molgan-tellus/1s_tps62823/jlcpcb_order/jlcpcb_respons/large/top_large.png

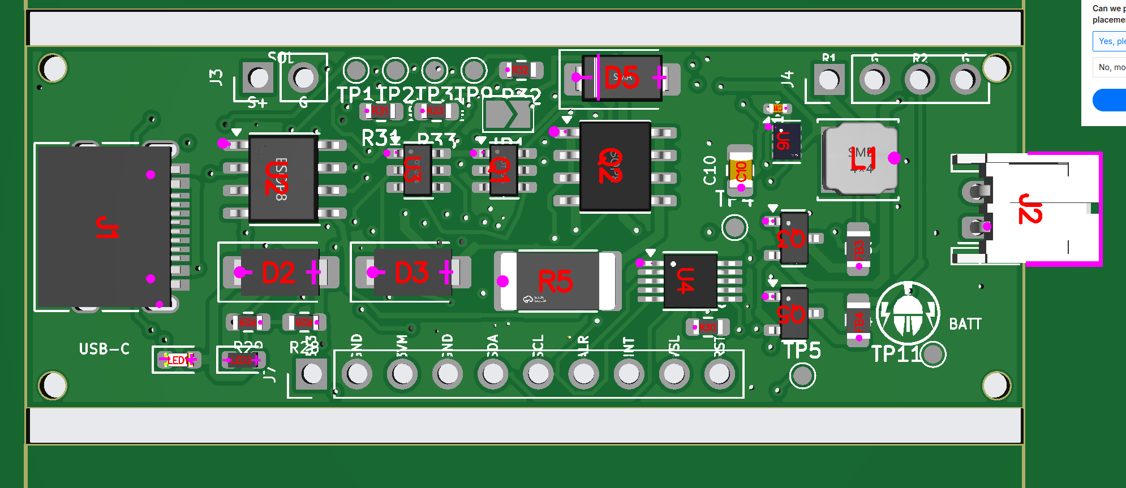
jlcpcb_order/jlcpcb_respons/large/top_large.png
