molgan-tellus/1s_tps62823/doc/jlpcb_a.png

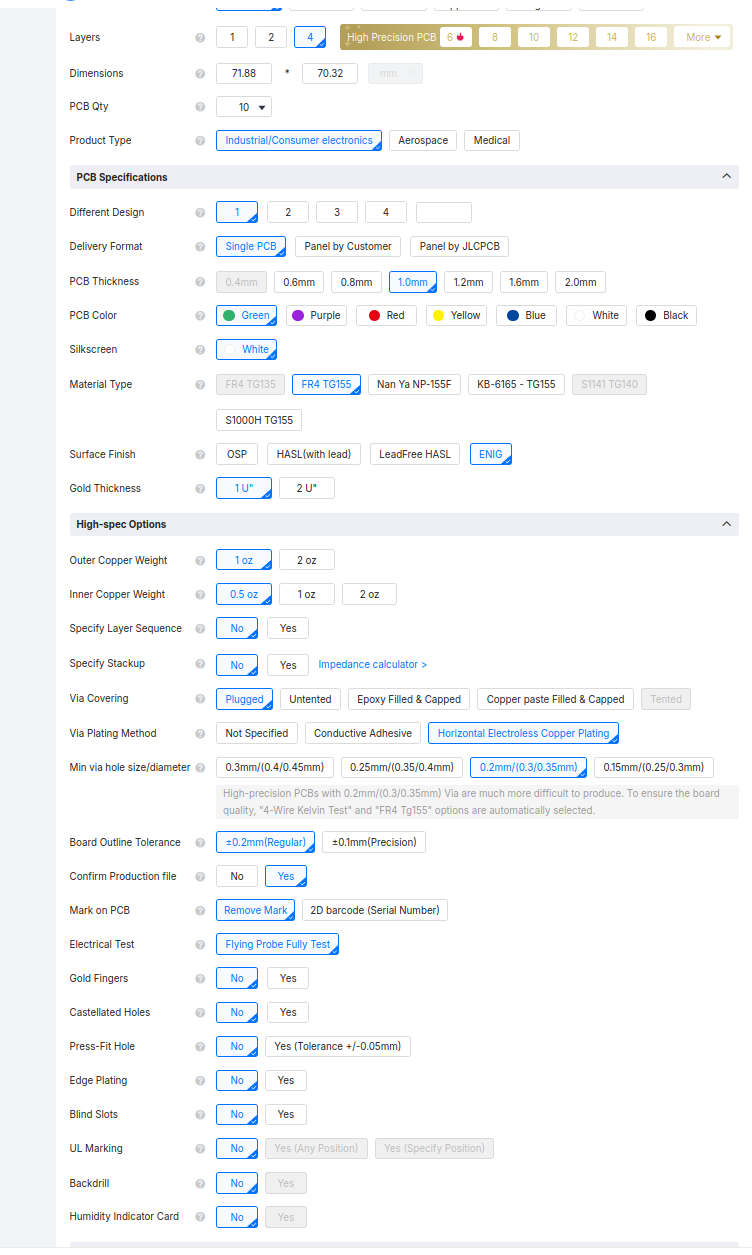
doc/jlpcb_a.png
