molgan-tellus/1s_tps62823/doc/jlpcb_b.png

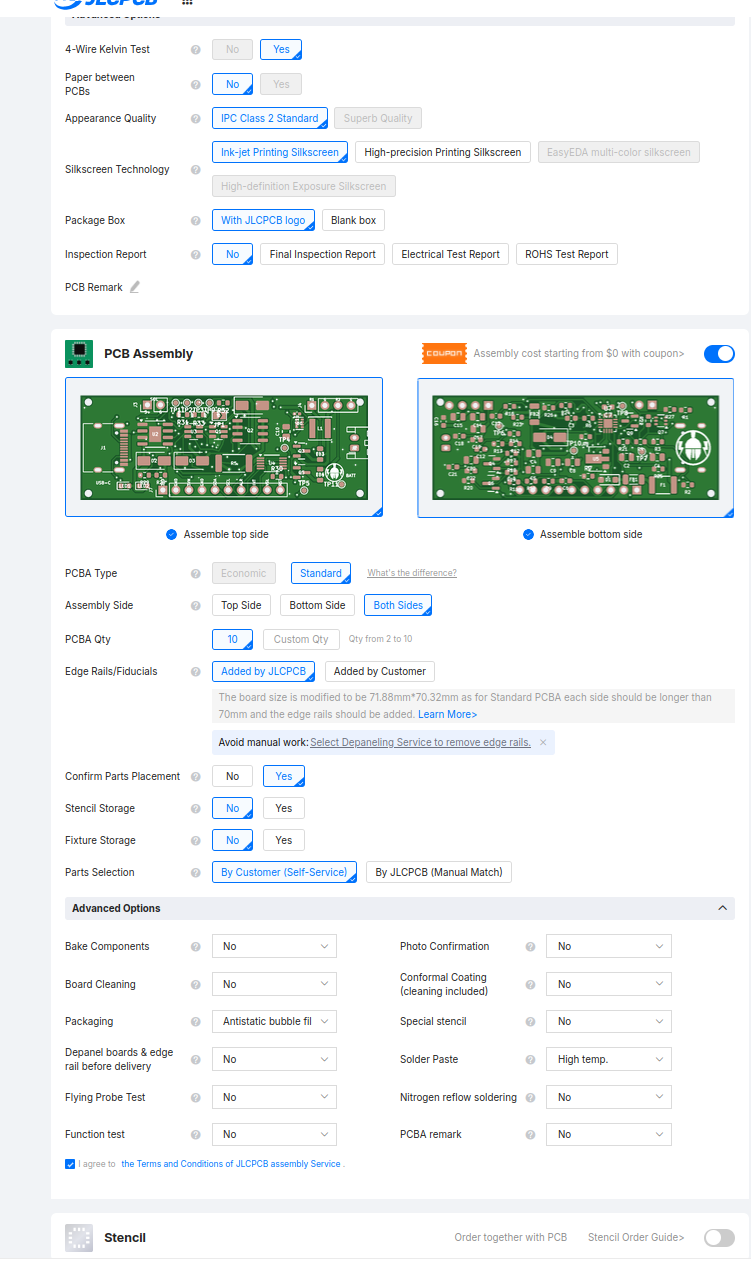
doc/jlpcb_b.png
