molgan-tellus/1s_tps62823/doc/render_back.png

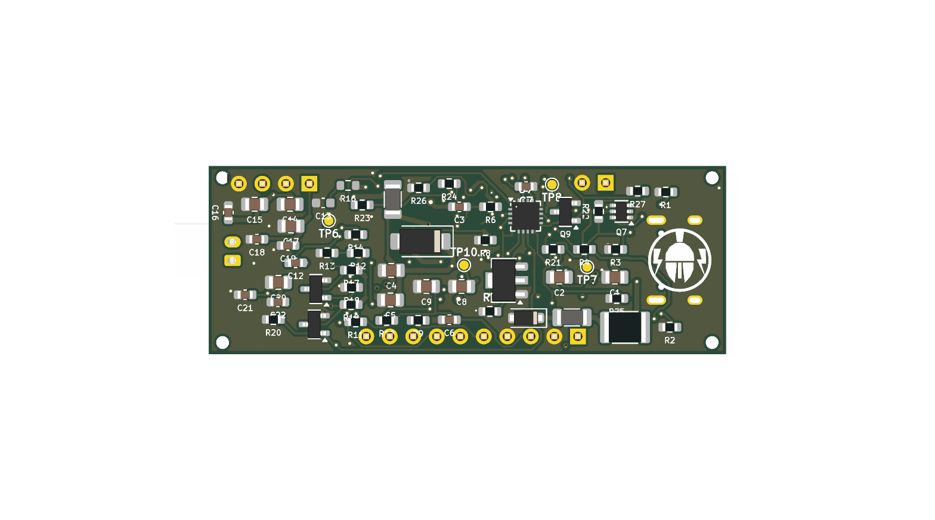
doc/render_back.png
