molgan-tellus/1s_tps62823/doc/render_front.png

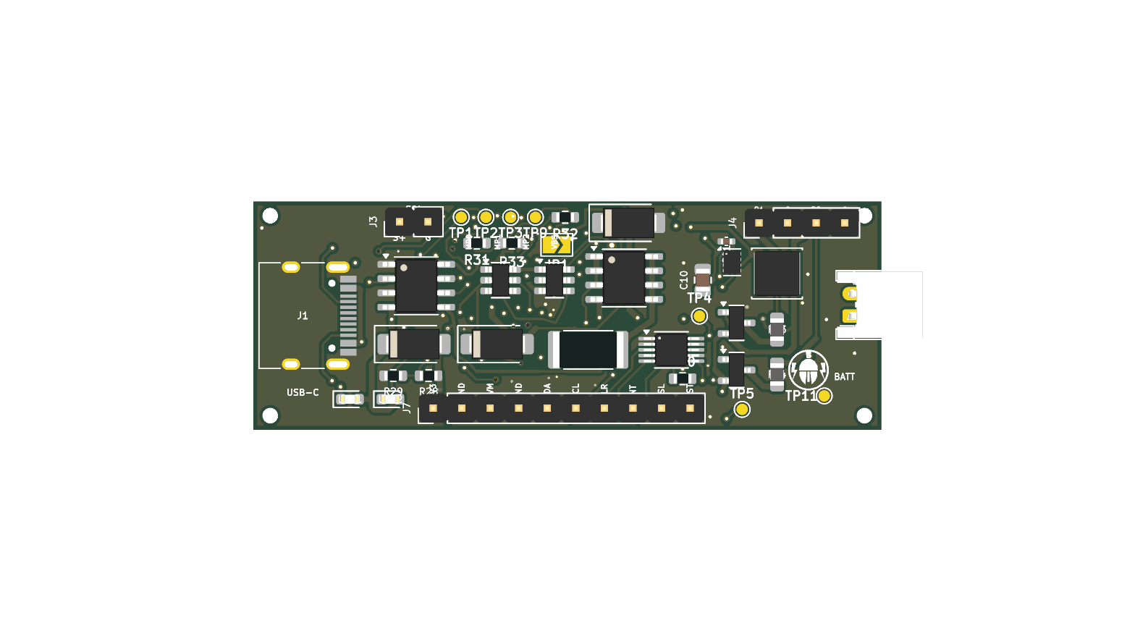
doc/render_front.png
