molgan-tellus/1s_tps62823/doc/render_persp.png

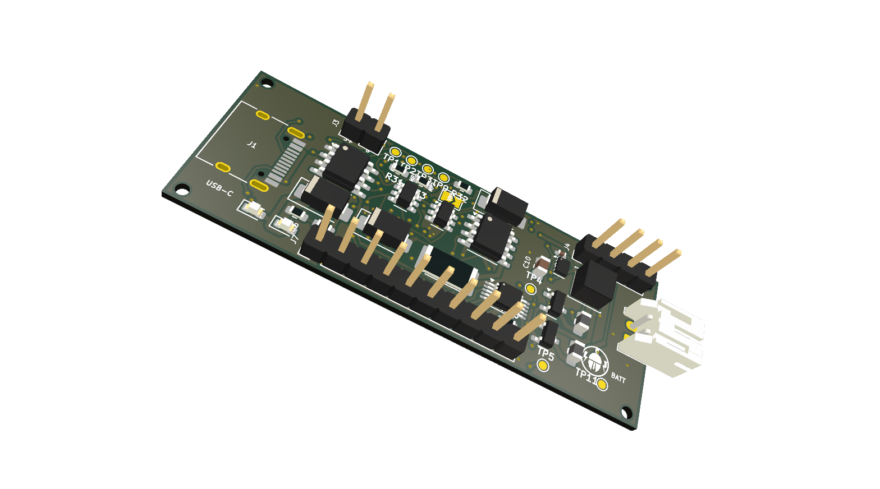
doc/render_persp.png
