molgan-tellus/1s_tps62823/jlcpcb_order/jlcpcb_respons/bom0.png

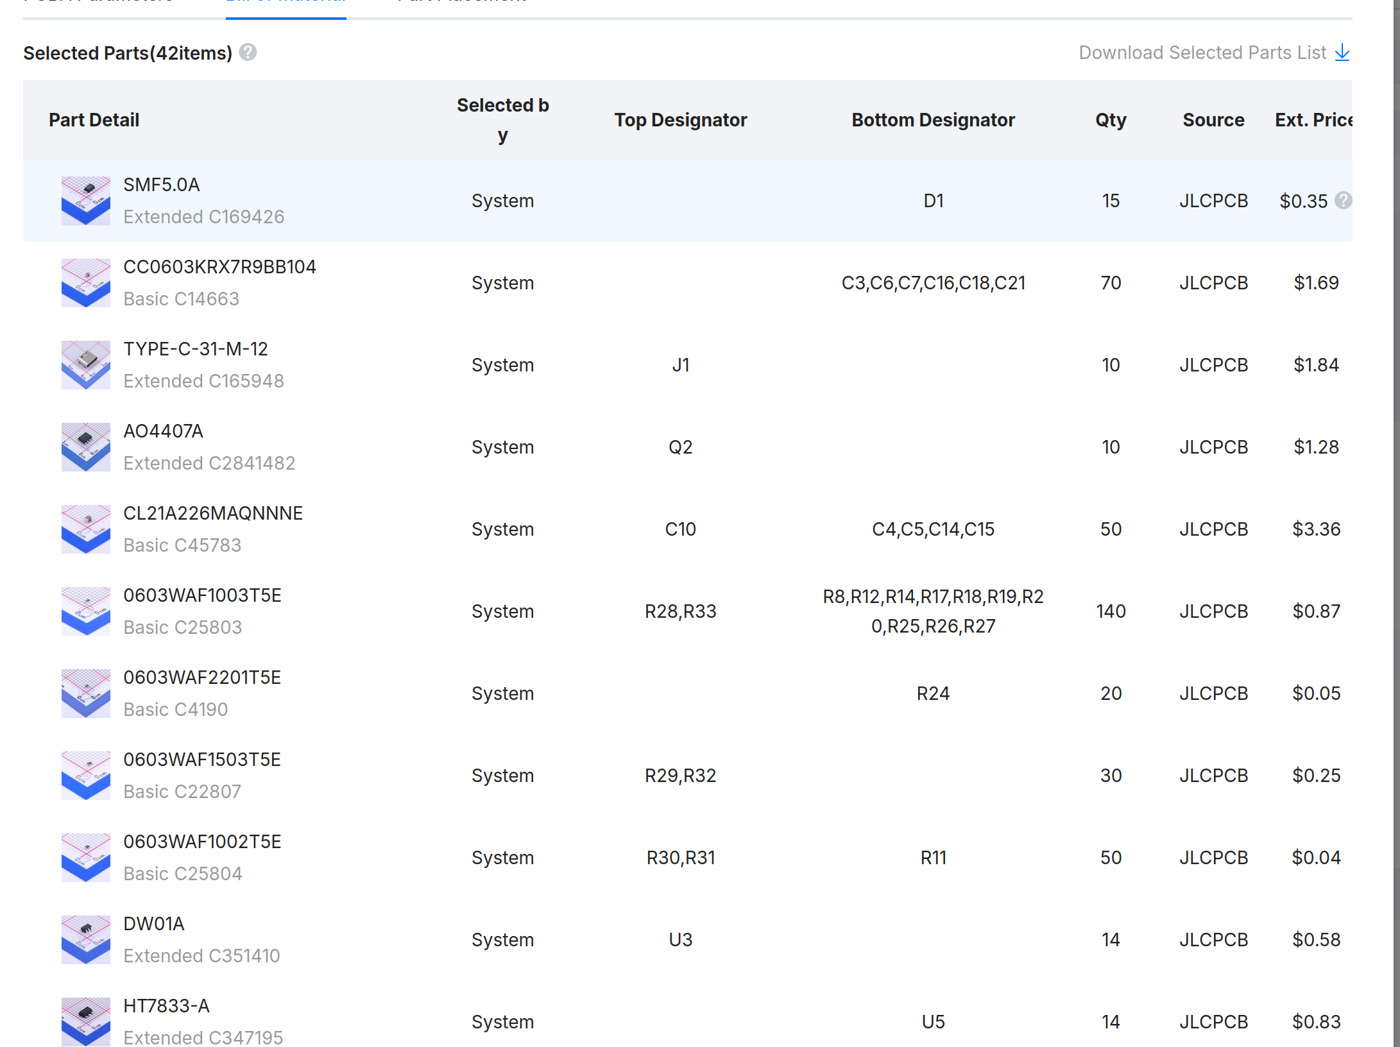
jlcpcb_order/jlcpcb_respons/bom0.png
