molgan-tellus/1s_tps62823/jlcpcb_order/jlcpcb_respons/bom2.png

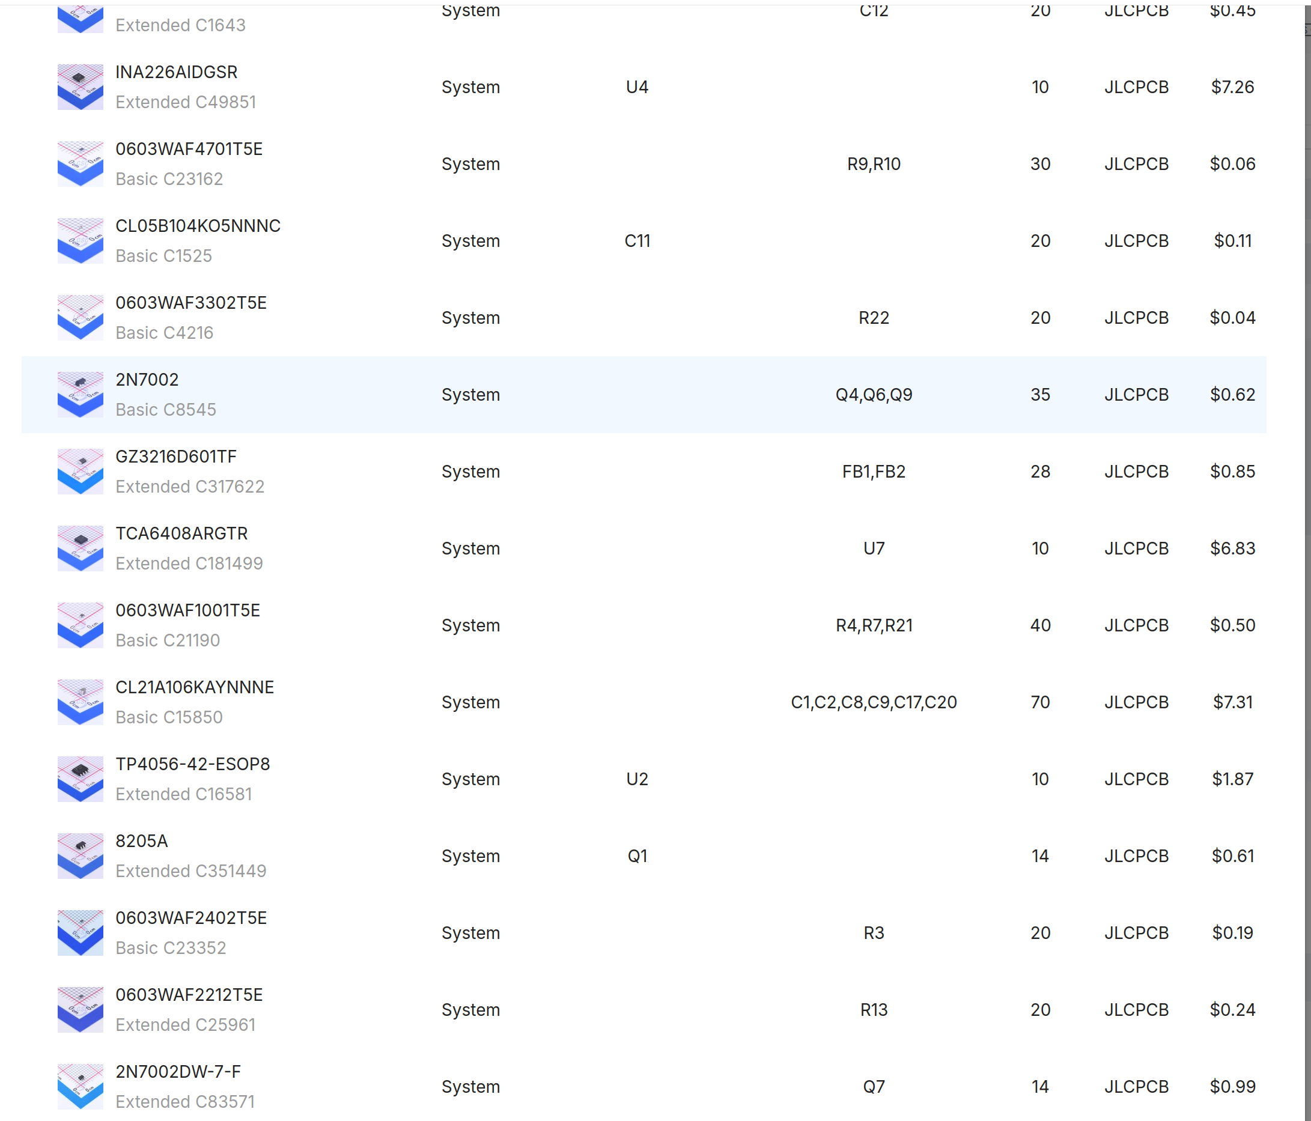
jlcpcb_order/jlcpcb_respons/bom2.png
