molgan-tellus/1s_tps62823/jlcpcb_order/jlcpcb_respons/bom3.png

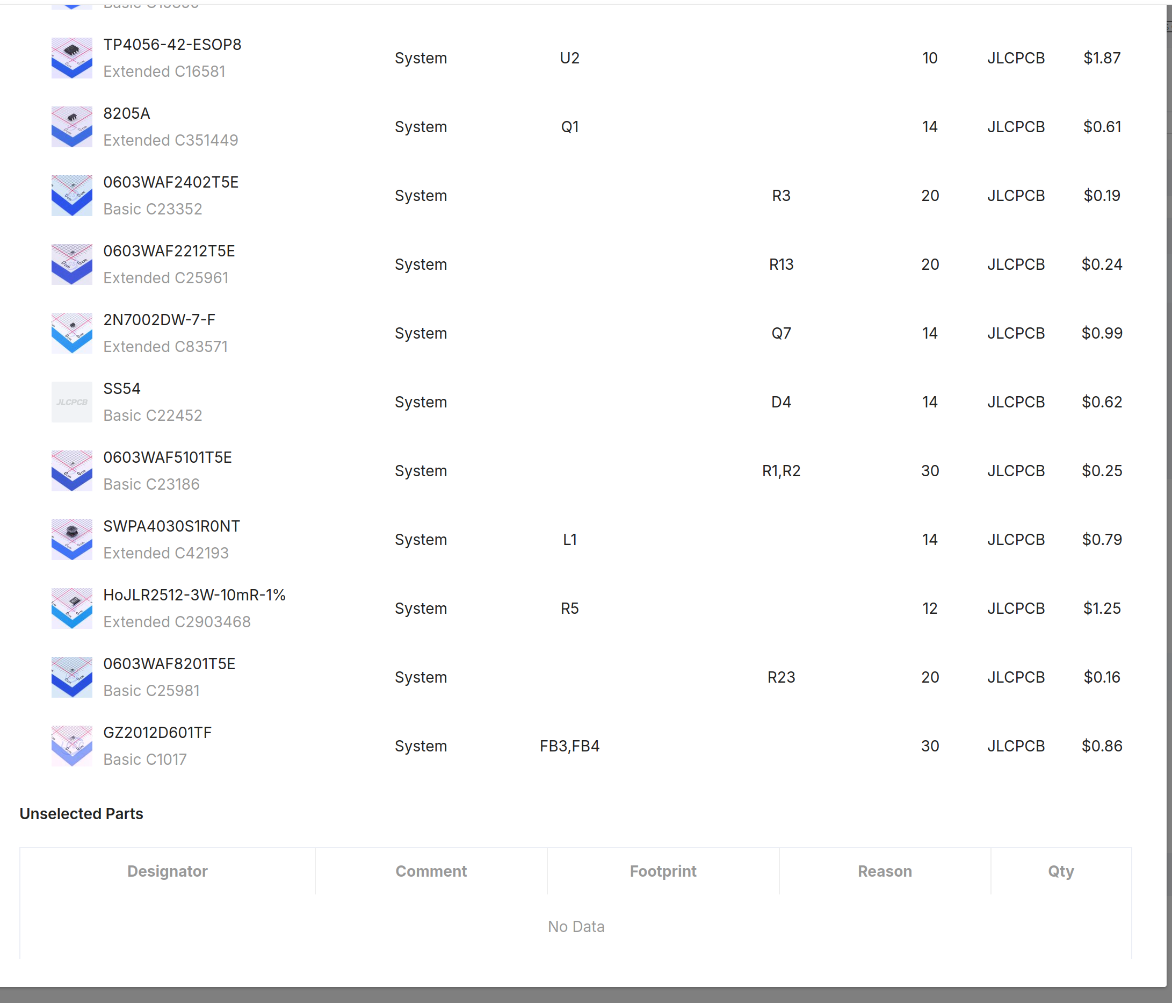
jlcpcb_order/jlcpcb_respons/bom3.png
