molgan-tellus/1s_tps62823/jlcpcb_order/jlcpcb_respons/bottom_correction.png

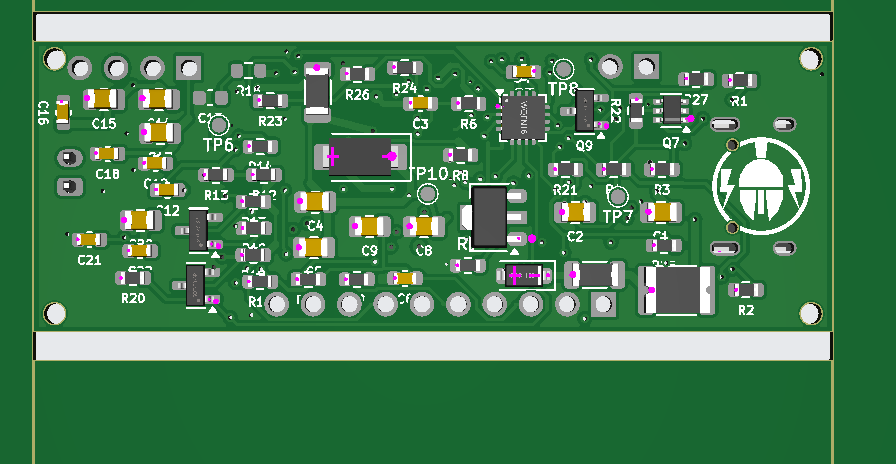
jlcpcb_order/jlcpcb_respons/bottom_correction.png
