molgan-tellus/1s_tps62823/jlcpcb_order/jlcpcb_respons/placement.png

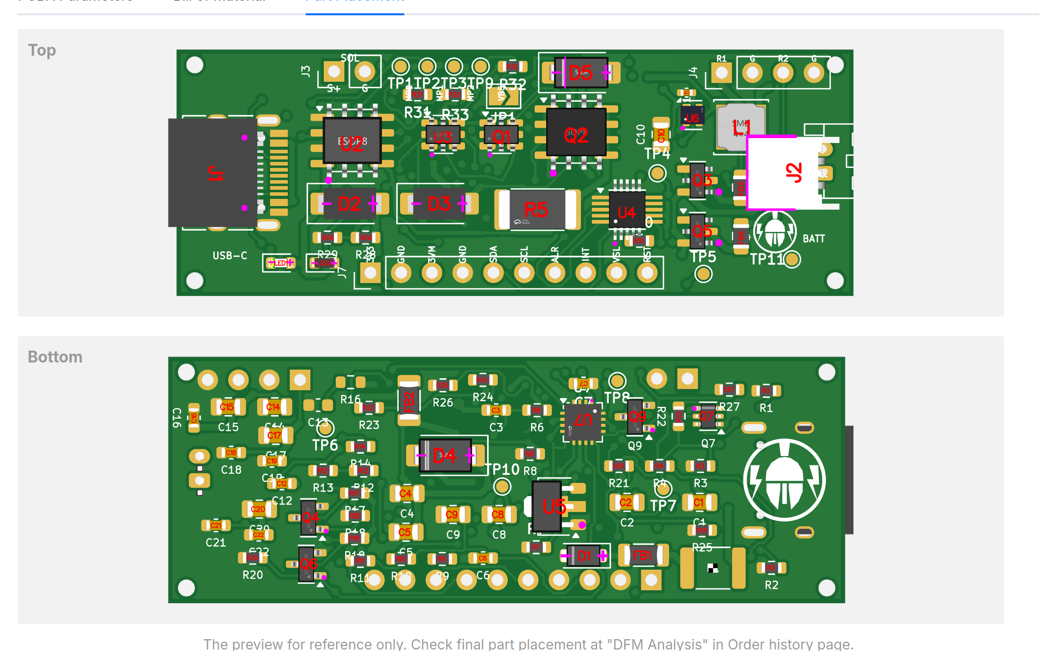
jlcpcb_order/jlcpcb_respons/placement.png
