molgan-tellus/1s_tps62823/jlcpcb_order/jlpcb_b_markerad.png

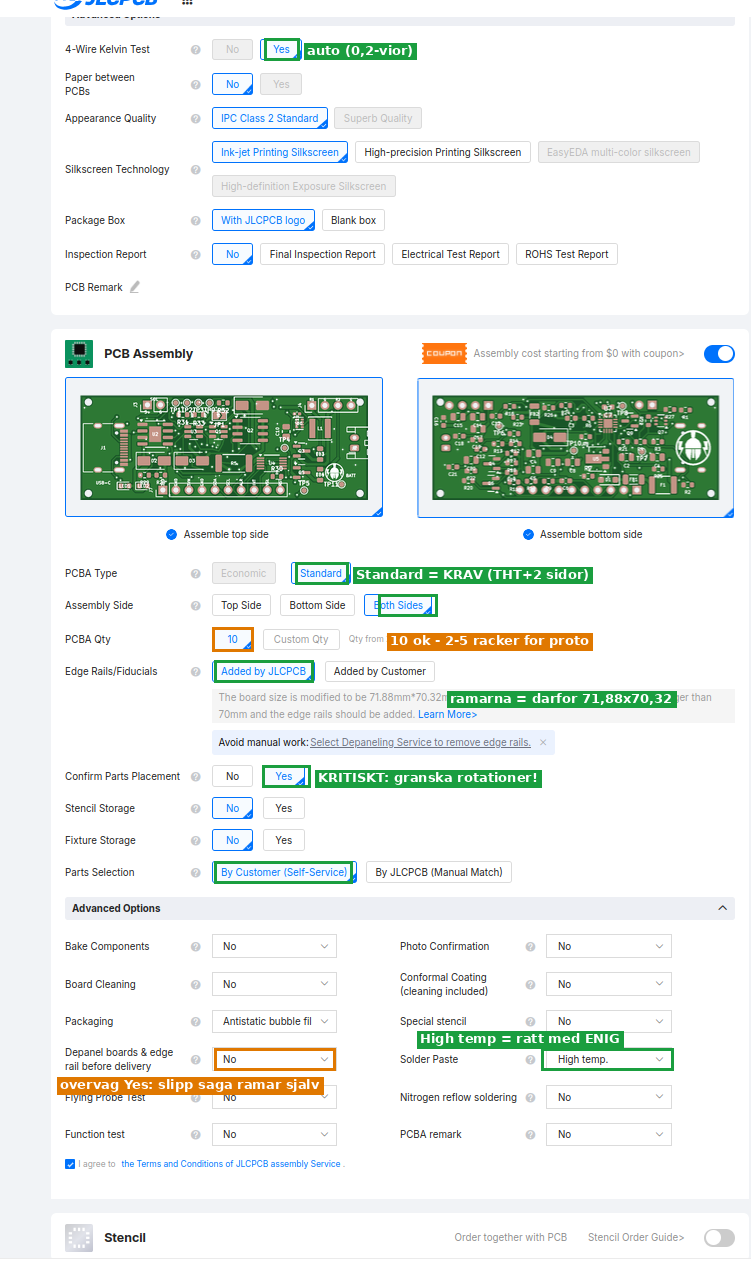
jlcpcb_order/jlpcb_b_markerad.png
