molgan-tellus/1s_tps62823/power_kicad.kicad_pcb

## KiCad design power_kicad.kicad_pcb (2026-08-03)

Schematic: power_kicad.kicad_sch, LiPo power board - 2x SX1262 + MCU

Parts:
C1, C2, C8, C9, C17, C20: 10uF; C_0805_2012Metric
C3, C6, C7, C16, C18, C21: 100nF; C_0603_1608Metric
C4, C5, C10, C14, C15: 22uF; C_0805_2012Metric
C11: 100nF; C_0402_1005Metric
C12: 120pF; C_0603_1608Metric
C13: 470pF DNP; C_0603_1608Metric; not fitted
C19, C22: 100pF; C_0603_1608Metric
D1: SMF5.0A; D_SOD-123F; LCSC C169426
D2, D3: SS34; D_SMA; LCSC C8678
D4: SS54; D_SMA; LCSC C22452
D5: 6.8V zener; D_SMA; LCSC C382952
F1: mSMD200 2A; Fuse_1812_4532Metric; LCSC C5128770
FB1, FB2: 600R@100MHz 3A; L_1206_3216Metric; LCSC C317622
FB3, FB4: 600R@100MHz; L_0805_2012Metric; LCSC C1017
J1: USB-C 5V; USB_C_Receptacle_HRO_TYPE-C-31-M-12; LCSC C165948
J2: LIPO 3000mAh; JST_PH_S2B-PH-K_1x02_P2.00mm_Horizontal; LCSC C173752
J3: SOLCELL <=6V HAL; PinHeader_1x02_P2.54mm_Vertical
J4: RF-HAL: RF1 G RF2 G; PinHeader_1x04_P2.54mm_Vertical
J7: MCU CTRL; PinHeader_1x10_P2.54mm_Vertical
JP1: VSOL-BYGEL; SolderJumper-2_P1.3mm_Open_TrianglePad1.0x1.5mm
L1: 1uH SWPA4030S; L_Sunlord_SWPA4030S; LCSC C42193
LED1: ROD CHRG; LED_0603_1608Metric; LCSC C2286
LED2: GRON STDBY; LED_0603_1608Metric; LCSC C12624
Q1: 8205A; SOT-23-6; LCSC C351449
Q2: AO4407A; SOIC-8_3.9x4.9mm_P1.27mm; LCSC C2841482
Q3, Q5: AO3401A; SOT-23; LCSC C15127
Q4, Q6, Q9: 2N7002; SOT-23; LCSC C8545
Q7: 2N7002DW-7-F; SOT-363_SC-70-6; LCSC C83571
R1, R2: 5.1k; R_0603_1608Metric
R3: 24k; R_0603_1608Metric; LCSC C23352
R4, R7, R21: 1k; R_0603_1608Metric
R5: 10mR 1% 3W; R_2512_6332Metric; LCSC C2903468
R6: 330R; R_0603_1608Metric
R8, R12, R14, R17, R18, R19, R20, R25, R26, R27, R28, R33: 100k; R_0603_1608Metric
R9, R10: 4.7k; R_0603_1608Metric
R11, R30, R31: 10k; R_0603_1608Metric
R13: 22.1k; R_0603_1608Metric
R16: 2R SNUB DNP; R_0603_1608Metric; not fitted
R22: 33k; R_0603_1608Metric; LCSC C4216
R23: 8.2k; R_0603_1608Metric; LCSC C25981
R24: 2.2k; R_0603_1608Metric; LCSC C4190
R29, R32: 150k; R_0603_1608Metric; LCSC C22807
TP1: MP0; TestPoint_Pad_D1.0mm
TP2: MP1; TestPoint_Pad_D1.0mm
TP3: MP2; TestPoint_Pad_D1.0mm
TP4: EN_RF1; TestPoint_Pad_D1.0mm
TP5: EN_RF2; TestPoint_Pad_D1.0mm
TP6: BUCK_EN; TestPoint_Pad_D1.0mm
TP7: PROG; TestPoint_Pad_D1.0mm
TP8: VBS; TestPoint_Pad_D1.0mm
TP9: VSOL; TestPoint_Pad_D1.0mm
TP10: SYS; TestPoint_Pad_D1.0mm
TP11: GND; TestPoint_Pad_D1.0mm
U2: TP4056; SOIC-8-1EP_3.9x4.9mm_P1.27mm_EP2.29x3mm; LCSC C16581
U3: DW01A; SOT-23-6; LCSC C351410
U4: INA226; VSSOP-10_3x3mm_P0.5mm; LCSC C49851
U5: HT7833-A; SOT-89-3; LCSC C347195
U6: TPS62823DLCR; VSON-8_1.5x2mm_P0.5mm; LCSC C2693497
U7: TCA6408ARGTR; VQFN-16-1EP_3x3mm_P0.5mm_EP1.68x1.68mm; LCSC C181499

Connections:
3V3: C12.1, C14.1, C15.1, C16.1, J7.1, L1.2, Q3.2 (S), Q5.2 (S), R12.1, R17.1, R19.1
3V3_MCU: C6.1, C7.1, C9.1, J7.3, R9.1, R10.1, R11.1, R30.1, R31.1, U4.6 (VS), U5.3 (VOUT), U7.14 (VCCP), U7.15 (VCCI)
3V3_RF1: C17.1, C18.1, C19.1, FB3.2, J4.1
3V3_RF2: C20.1, C21.1, C22.1, FB4.2, J4.3
ALERT: J7.7, R11.2, U4.3 (ALERT)
BAT_P: C2.1, Q2.5 (D), Q2.6 (D), Q2.7 (D), Q2.8 (D), R5.2, U2.5 (BAT), U4.9 (IN-)
BUCK_EN: R14.1, TP6.1, U6.1 (EN), U7.8 (P5)
CC1: J1.A5 (CC1), R1.1
CC2: J1.B5 (CC2), R2.1
CELL_N: C3.2, J2.2, Q1.1 (S1), U3.6 (GND)
CELL_P: J2.1, R5.1, R6.1, U4.8 (VBUS), U4.10 (IN+)
CHG_VIN: C1.1, D2.1 (K), D3.1 (K), LED1.2 (A), LED2.2 (A), R32.1, U2.4 (VCC), U2.8 (CE)
CHRG: R4.2, U2.7 (CHRG)
DD: Q1.2 (D), Q1.5 (D)
DW_VCC: C3.1, R6.2, U3.5 (VCC)
EN_RF1: Q4.1 (G), R18.1, TP4.1, U7.5 (P3)
EN_RF2: Q6.1 (G), R20.1, TP5.1, U7.7 (P4)
FB_BK: C12.2, R12.2, R13.1, U6.2 (FB)
G1: Q1.6 (G1), U3.1 (OD)
G2: Q1.4 (G2), U3.3 (OC)
GND: C1.2, C2.2, C4.2, C5.2, C6.2, C7.2, C8.2, C9.2, C10.2, C11.2, C13.2, C14.2, C15.2, C16.2, C17.2, C18.2, C19.2, C20.2, C21.2, C22.2, D1.2 (A), D5.2 (A), J1.A1 (GND), J1.A12 (GND), J1.B1 (GND), J1.B12 (GND), J1.S1 (SHIELD), J3.2, J4.2, J4.4, J7.2, J7.4, Q1.3 (S2), Q4.2 (S), Q6.2 (S), Q7.1 (S2), Q7.4 (S1), Q9.2 (S), R1.2, R2.2, R3.2, R7.2, R8.2, R13.2, R14.2, R18.2, R20.2, R25.2, R26.2, R27.2, R29.2, R33.2, TP11.1, U2.1 (TEMP), U2.3 (GND), U2.9 (EP), U4.1 (A1), U4.2 (A0), U4.7 (GND), U5.1 (GND), U6.3 (AGND), U6.4 (NC), U6.5 (PGND), U7.6 (GND), U7.10 (P7), U7.16 (ADDR), U7.17 (EP)
G_RF1: Q3.1 (G), Q4.3 (D), R17.2
G_RF2: Q5.1 (G), Q6.3 (D), R19.2
INT_EXP: J7.8, R31.2, U7.11 (INT)
LED1K: LED1.1 (K), R4.1
LED2K: LED2.1 (K), R21.1
MP0: Q7.5 (G1), R25.1, TP1.1, U7.2 (P0)
MP1: Q7.2 (G2), R26.1, TP2.1, U7.3 (P1)
MP2: Q9.1 (G), R27.1, TP3.1, U7.4 (P2)
PGA: Q7.3 (D1), R22.2
PGB: Q7.6 (D2), R23.2
PGC: Q9.3 (D), R24.2
PROG: R3.1, R22.1, R23.1, R24.1, TP7.1, U2.2 (PROG)
RST_EXP: J7.10, R30.2, U7.1 (RESET)
SCL: J7.6, R10.2, U4.5 (SCL), U7.12 (SCL)
SDA: J7.5, R9.2, U4.4 (SDA), U7.13 (SDA)
SNUB: C13.1, R16.2
SOLAR_P: D3.2 (A), D5.1 (K), J3.1
STDBY: R21.2, U2.6 (STDBY)
SW_BK: L1.1, R16.1, U6.6 (SW)
SW_RF1: FB3.1, Q3.3 (D)
SW_RF2: FB4.1, Q5.3 (D)
SYS: C4.1, C5.1, C8.1, D4.1 (K), FB2.1, Q2.1 (S), Q2.2 (S), Q2.3 (S), TP10.1, U5.2 (VIN)
VBS: R28.2, R29.1, TP8.1, U7.9 (P6)
VBUS: D1.1 (K), D2.2 (A), D4.2 (A), FB1.2, Q2.4 (G), R8.1, R28.1
VBUS_F: F1.2, FB1.1
VBUS_RAW: F1.1, J1.A4 (VBUS), J1.A9 (VBUS), J1.B4 (VBUS), J1.B9 (VBUS)
VIN_BK: C10.1, C11.1, FB2.2, U6.7 (VIN)
VM: R7.1, U3.2 (VM)
VSOL: JP1.1, R32.2, R33.1, TP9.1
VSOL_J: J7.9, JP1.2

Notes on the sheet:
USB-C 5V IN + SKYDD
LADDNING TP4056 (USB + SOL)
BATTERI + CELLSKYDD + SHUNT
POWER PATH (USB-PRIORITET, IDEAL-DIOD-BETEENDE)
STROMMATNING INA226 (I2C)
ALLTID-PA LDO 3V3_MCU
BUCK 3V3 3A TPS62823 + AVSTORNING
LASTBRYTARE + PI-FILTER RADIO 1 (SX1262)
LASTBRYTARE + PI-FILTER RADIO 2 (SX1262)
GPIO-EXPANDER TCA6408A (I2C 0x20): MPPT + EN + VBS, VSOL-DELARE
TESTPUNKTER (FRI KOPPAR)
MCU-ANSLUTNING (nRF52840 CONNECT KIT: 3V3 + I2C + IRQ + VSOL)

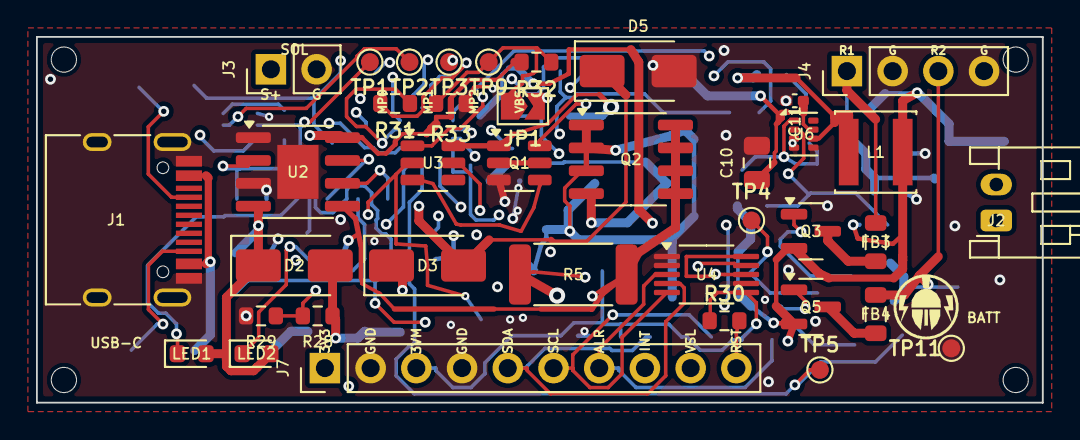
[picture p17: board power_kicad.kicad_pcb from above]

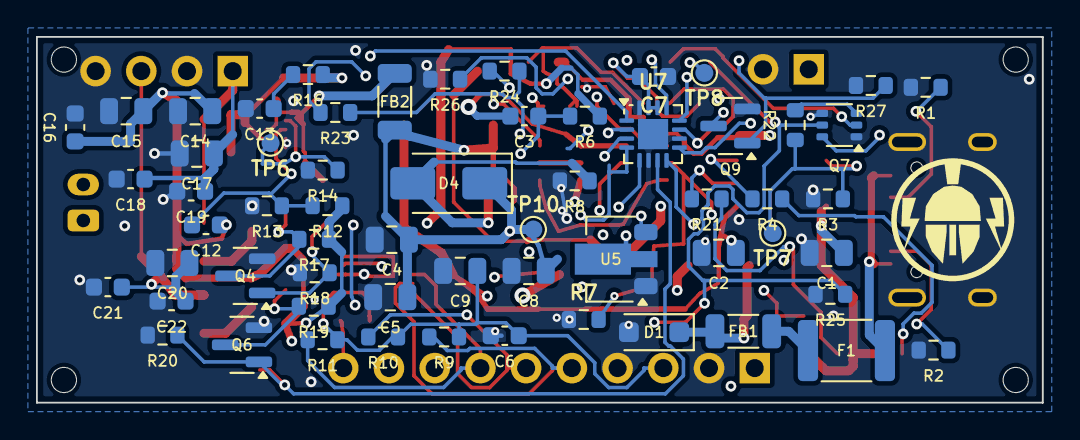
[picture p18: board power_kicad.kicad_pcb from below]

Board: 4 copper layers, 55.9 x 20.3 mm, 102 parts (60 on the bottom side), 51 nets.

Other parts of the board:
H1, H2, H3, H4: (no value)
