molgan-tellus/1s_tps62823/(commit log)

2026-08-03 Initial import: LiPo-kraftmodul för LoRa-noder, rev A.2 (beställd hos JLCPCB 2026-08-02)
    KiCad 9-projekt: TP4056-laddning USB-C/sol med MPPT-steg, DW01A+8205A cellskydd,
    INA226 strömmätning, TCA6408A GPIO-expander, TPS62823 3A buck, 2× brytbara
    π-filtrerade radiorails. ERC 0, DRC 0. Se CLAUDE.md, STATUS.md och doc/DESIGN.md.
    [BOM.csv, bom_raw.csv, pos_raw.csv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]
2026-08-04 Lägg till lokalt cachade datablad för alla BOM-delar (<MPN>_<LCSC-nr>.pdf)
2026-08-04 hw_spec: nytt avsnitt MCU-styrning (firmwarekrav) + verkliga strömgränser, rev A.2
    Init-sekvens (SCL-recovery, output-före-config), 330 µA-fällan vid uppvak,
    lastsekvensering buck→radio, MPPT P&O-rutin, Kelvin-kalibrering och
    INA226-VS-gränsen. Gränsvärdestabellen: hårt tak ~2,4–2,7 A (DW01A).
    .odt/.pdf regenererade från doc/hw_spec.md (pandoc + soffice) — fixar
    även den släpande 5,5 V-raden; STATUS.md-noteringen struken.
2026-08-04 hw_spec: minimalt setup-exempel (Arduino-stil) i §MCU-styrning
    Inkoppling J2/J7 + kod som följer tvingande ordningen: expander
    output→config, INA226-kalibrering, buck→radio med fördröjningar,
    strömavläsning och INT-latch-släpp. .odt/.pdf regenererade.
